Lock-Lee/Drumduino/hardware/enclosure/README.md

# กล่อง DrumDuino (สำหรับพิมพ์ 3D)

กล่องสำหรับแผ่น DrumDuino carrier v2 ขนาดภายนอกประมาณ **145.6 × 125.6 × 30.4 มม.**
กล่องแบ่งเป็น 2 ชิ้น คือ **ฐาน** กับ **ฝา** รอยแยกอยู่ตรงระดับกึ่งกลางรูแจ็คพอดี
รูแจ็คจึงเป็นครึ่งวงกลมทั้งในฐานและในฝา วางแผ่นที่บัดกรีแจ็คแล้วลงในฐานได้ตรง ๆ

## ไฟล์
- `drumduino-enclosure-base.stl` ฐาน พิมพ์โดยให้พื้นกล่องคว่ำลงบนฐานพิมพ์
- `drumduino-enclosure-lid.stl` ฝา หมุนไว้แล้ว ให้ผิวด้านบนของฝาวางบนฐานพิมพ์
- `drumduino-enclosure.scad` ไฟล์ต้นแบบ เปิดด้วย OpenSCAD เพื่อแก้ขนาดได้
- `drumduino-enclosure-*.png` ภาพตัวอย่าง

## การพิมพ์
- ใช้ PLA หรือ PETG ความหนาชั้น 0.2 มม. ผนัง 3 ชั้น เติมเนื้อใน 20%
- ไม่ต้องใช้ support เพราะรูครึ่งวงกลมอยู่ที่ขอบชิ้นงานพอดี

## การประกอบ
1. บัดกรีอุปกรณ์ทั้งหมดลงแผ่น รวมทั้งแจ็ค 16 ตัว
2. วางแผ่นลงในฐาน ให้หัวแจ็คลงในร่องครึ่งวงกลม และรูยึดแผ่นตรงกับเสารอง 4 ต้น
3. ปิดฝา
4. ใส่สกรู **M3 × 25 มม.** 4 ตัวจากใต้ฐาน สกรูจะทะลุเสารอง ผ่านรูของแผ่น แล้วเกลียวเข้าเสาของฝา
   เสาของฝาจะกดแผ่นลงบนเสารอง ทำให้แผ่นแน่น
5. ขันน็อตของแจ็คจากด้านนอกผนัง น็อตจะรับแรงเสียบสายแทนจุดบัดกรี
6. ติดยางรองใต้กล่อง 4 จุด เพราะหัวสกรูยื่นออกมาใต้ฐาน

## ค่าที่ควรวัดจากของจริงก่อนพิมพ์
ค่าเหล่านี้อยู่ส่วนบนของไฟล์ `.scad` ให้แก้ แล้วกด F6 และ Export STL ใหม่
| ค่า | ที่ตั้งไว้ | ความหมาย |
|---|---|---|
| `jack_axis_h` | 6.3 มม. | ความสูงจุดกลางหัวแจ็คจากผิวแผ่น ค่านี้กำหนดตำแหน่งรอยแยกฝากับฐานด้วย |
| `dc_axis_h` | 6.5 มม. | ความสูงจุดกลางรูแจ็คไฟ DC |
| `usb_axis_h` | 9.6 มม. | ความสูงจุดกลางพอร์ต USB ซึ่งอยู่ใต้บอร์ด Mega PRO |
| `screw_pilot_d` | 2.6 มม. | รูนำในเสาของฝาสำหรับสกรู M3 ถ้าแน่นไปให้เพิ่มเป็น 2.7 |

ตัวเลขชุดนี้ประมาณจากโมเดล 3D แบบคร่าว ๆ เพราะเปิดสเปคของจริงไม่ได้
**แนะนำให้พิมพ์ฐานก่อน 1 ชิ้นแล้วลองวางแผ่นจริง** ถ้าตรงแล้วค่อยพิมพ์ฝา

ไฟล์ `.scad` สร้างจาก `../gen_enclosure.py` ซึ่งอ่านตำแหน่งแจ็ค รูยึด และแจ็คไฟจากไฟล์ PCB โดยตรง
ถ้าแก้แผ่น PCB ให้รันสคริปต์ใหม่ กล่องจะตรงกับแผ่นเสมอ
