Lock-Lee/Drumduino/README.th.md

# DrumDuino

[English](README.md) · **ภาษาไทย**

แอปกลองไฟฟ้าสำหรับ macOS และ Windows ที่ต่อกับ Arduino และเซนเซอร์ piezo
ตีแป้นแล้วได้เสียงกลองจริง ฝึกตีตามโน้ตพร้อมเพลงต้นฉบับ และอัดคลิปลงโซเชียลได้ในแอปเดียว

หน้าฝึกตี: โน้ตกลอง เพลงประกอบที่ซิงก์แล้ว และชุดกลอง 3 มิติที่ไม้ตีตามโน้ต

## สิ่งที่ทำได้

**เสียงกลอง**
- ชุดกลองให้เลือก 6 ชุด: Studio Maple, Black Pearl, Red Zeppelin, Arena Metal, Salamander Garage (กลองอะคูสติกจริง หลายระดับแรงตี) และ Synth Kit
- ทำสำเนาเป็น "ชุดของฉัน" แล้วแก้เสียงได้ ปรับ EQ ทุ้ม / กลาง / แหลม แยกแต่ละชิ้น
- **ใส่ไฟล์เสียงเองได้หลายไฟล์ต่อชิ้น**: .wav .mp3 .ogg .flac .aiff (ลากมาวางได้) เล่นตามแรงตี (velocity layers) · วนตามลำดับ (round robin) · สุ่ม
- ปรับความดัง, pitch, ความไวเซนเซอร์, scan / mask time แยกแต่ละชิ้น แล้วส่งค่าไปบอร์ดให้อัตโนมัติ
- **ตีขอบได้ (dual-zone)**: piezo หนัง + piezo ขอบ มีเสียงขอบแยก (rimshot, ride bell, ขอบทอม)
- **แป้นไฮแฮท**: ปิด / ครึ่งเปิด / เปิด ตามความลึกที่เหยียบ, เสียงเหยียบ (chick), ปิดแป้นแล้วไฮแฮทเปิดหยุดทันที (choke), รองรับ MIDI CC4

**ฝึกตี**
- โน้ตกลองบนบรรทัด 5 เส้นแบบมาตรฐาน มีเคอร์เซอร์วิ่งตาม คลิกห้องไหนก็เริ่มเล่นจากห้องนั้น
- โหมด **แอปตีให้ฟัง** และ **ฉันตีเอง** (บอกว่าตีเร็ว / ช้ากี่ ms พร้อมคะแนน) · เมโทรนอม · นับก่อนเริ่ม · ปรับ BPM · วนซ้ำเฉพาะห้อง · เปลี่ยนชุดกลองได้ในหน้านี้
- **แท็บฝึกแบบเลน**: โน้ตวิ่งเป็นเลนสีตามแต่ละชิ้น บอกมือ L / R และเท้า RF / LF บนทุกโน้ต พร้อมชุดกลองนีออน
- **ชุดกลอง 3 มิติ**: ไม้กลองตีตามโน้ตจริงแบบลื่นเหมือนมือจับ (เงื้อรอโน้ตถัดไป แล้วฟาดลงตรงจังหวะ) สลับมือซ้าย-ขวาแบบมือกลอง (รัว / ฟิลล์ใช้ R L R L) ฉาบโยก หัวกระเดื่องฟาด คลิกที่กลองเพื่อตี ลากเพื่อหมุนมุมมอง
- **เพลงประกอบ + Auto Sync (ซิงก์เพลงอัตโนมัติ)**: ใส่ไฟล์เพลงจริง แอปหาเองว่าห้อง 1 อยู่วินาทีไหนและเพลงเร็วกี่ BPM แล้วเล่นเพลงตรงกับโน้ตทั้งเพลง ลดความเร็วแล้วเสียงไม่เพี้ยน
- จังหวะสำเร็จรูป (ร็อก ป๊อป ฟังก์ ดิสโก้ ชัฟเฟิล สวิง บอสซา 6/8 ลูกส่ง เพลงฝึกแบบมีท่อน) และนำเข้าโน้ตจาก MIDI / MusicXML (export จาก MuseScore ได้)

<p align="center">แท็บฝึกแบบเลน: ชุดกลองนีออน 3 มิติ ไม้กลอง L/R ยกขึ้นแล้วตีลงตามโน้ตที่วิ่งมาในเลน</p>

**อัดคลิป**
- **โหมดอัดคลิป** แนวตั้งหรือแนวนอน 16:9 ซ่อนเมนูทั้งหมด เหลือโน้ตกับชุดกลอง 3 มิติ
- สคริปต์ตั้งค่า OBS ให้ครบ ทั้ง Reels (9:16) และ YouTube (16:9): หน้าต่างแอปเต็มภาพ พร้อมเสียงจากเครื่อง

**ฮาร์ดแวร์**
- รับสัญญาณผ่าน USB Serial (ทุกบอร์ด) หรือ USB MIDI (Leonardo / Pro Micro) รองรับ Arduino Mega 16 ช่อง (A0–A15)
- มีแบบแผ่น PCB สำหรับ Mega 2560 PRO พร้อมแจ็ค 6.35 มม. 16 ช่อง และกล่องพิมพ์ 3D
- ไม่มี Arduino ก็ทดสอบด้วยคีย์บอร์ดได้ หรือ**ใช้ iPhone / iPad เป็นแป้นกลองไร้สาย**: เปิด *ตีจาก iPhone / iPad* ในแท็บฮาร์ดแวร์ แล้วสแกน QR แตะจอแล้วเสียงออกจาก Mac ผ่าน Wi-Fi (ชุดกลองแบบสมจริง กระเดื่องคู่ แตะหลายนิ้วพร้อมกันได้ ตีกลางแป้นดังกว่าขอบ กดค้างเพื่อเปิดไฮแฮท) กดเล่นแล้วจะมีวงแหวนสีหดเข้าหากลองที่ต้องตีถัดไป พร้อมบอกมือ L / R / RF / LF
- บันทึกอัตโนมัติ ไฟล์เสียงเก็บไว้ในเครื่อง

## ตัวอย่างการใช้งาน

### ตัวอย่างที่ 1: ฝึกตีตามเพลงจริงด้วย Auto Sync

1. ไปที่แท็บ **ฝึกตี** เลือกเพลงจากรายการทางซ้าย
2. ที่แถบ **เพลงประกอบ** กด **เลือกไฟล์เพลง…** แล้วเลือกไฟล์ mp3 / m4a / wav ของเพลงนั้น
3. รอ 3–5 วินาที แอปจะซิงก์ให้เอง แล้วขึ้นว่า ✓ ตรงกับโน้ตแล้ว
4. กด **Space** เพื่อเล่น เพลงจะเล่นอินโทรก่อน แล้วโน้ตเริ่มเดินตอนห้อง 1 พอดี

แถบเพลงประกอบหลังซิงก์: ห้อง 1 อยู่ที่ 0:04.0 ความเร็วจริง 145.9 BPM

ภาพนี้ใช้เพลงตัวอย่างที่สร้างจากโน้ต "เพลงฝึก: Arena Metalcore" (ในโน้ตเขียนไว้ 144 BPM)
โดยให้มีอินโทร 4 วินาทีก่อนกลองเข้า และเล่นเร็วกว่าโน้ตเล็กน้อยที่ 146 BPM
แอปหาได้ว่าห้อง 1 อยู่ที่ **0:04.0** และเพลงเร็ว **145.9 BPM** แล้วตั้งความเร็วตามเพลงให้เอง

| อยากทำ | ทำแบบนี้ |
|---|---|
| ฝึกช้าลง | เลื่อนแถบความเร็ว เพลงจะช้าลงตาม แต่เสียงร้องไม่เพี้ยน |
| ซ้อมเฉพาะท่อน | ใส่เลขห้องเริ่ม–จบ แล้วติ๊ก **วนซ้ำ** เพลงจะกระโดดตามไปท่อนนั้น |
| ได้ยินแต่เพลง แล้วตีเอง | เลือกโหมด **ฉันตีเอง** กลองของแอปจะเงียบ และมีคะแนนให้ |
| เพลงยังคลาดนิดหน่อย | กด **ปรับเอง** แล้วใช้ −/+ (เพลงมาก่อนกลอง → −, เพลงมาช้า → +) |

Auto Sync ได้ผลดีกับเพลงอัดในห้องอัดที่ความเร็วคงที่ และโน้ตเป็นเวอร์ชันเดียวกับไฟล์เพลง
ถ้าเพลงเร่งหรือช้าลงกลางเพลง หรือโน้ตมีจำนวนห้องไม่ตรงกับเพลง จะเริ่มคลาดตรงท่อนนั้น

### ตัวอย่างที่ 2: นำเข้าโน้ตจาก MuseScore

1. ใน MuseScore เปิดโน้ตกลองแล้วกด *File → Export → MIDI* (หรือ MusicXML)
2. ในแอปกด **นำเข้า MIDI / MusicXML** แล้วเลือกไฟล์

ถ้ามีหลายเพลง ให้กด **เปิดโฟลเดอร์** แล้ววางไฟล์ไว้ในโฟลเดอร์ `my-scores` แอปจะโหลดให้ทุกครั้งที่เปิด

```
my-scores/
├── เพลงที่ 1.mid
├── เพลงที่ 2.musicxml
└── ...
```

ตอนพัฒนาโฟลเดอร์นี้อยู่ที่ `./my-scores` ในโปรเจกต์ (ถูก gitignore ไว้ ไฟล์โน้ตส่วนตัวไม่ขึ้น git)
ส่วนแอปที่ติดตั้งแล้ว โฟลเดอร์จะอยู่ในโฟลเดอร์ข้อมูลของแอป
ชื่อท่อน (Marker) ในไฟล์ MIDI จะขึ้นเป็นกรอบชื่อท่อนบนโน้ต และกระโดดไปท่อนนั้นได้

### ตัวอย่างที่ 3: ใส่เสียงสแนร์ของตัวเอง 6 ระดับแรงตี

หน้าชุดกลอง: สแนร์มี 6 ไฟล์ แบ่งตามแรงตี 1–127

1. แท็บ **ชุดกลอง** กด **ทำสำเนา** เพื่อสร้างชุดของฉัน
2. คลิกที่ **Snare** แล้วลากไฟล์ `snare_01.wav` … `snare_06.wav` (เบาไปดัง) มาวางในกรอบด้านขวา
3. ตั้ง **การเล่นหลายไฟล์ → ตามแรงตี** แอปจะแบ่งช่วงแรงตีให้เอง (1–21, 22–42, … 107–127)
4. แท็บ **ตั้งค่า** ปรับความดัง pitch และ EQ ทุ้ม/กลาง/แหลม

### ตัวอย่างที่ 4: อัดคลิปตีกลองด้วย OBS

โหมดอัดคลิปแนวนอน 16:9: โน้ตด้านบน ชุดกลอง 3 มิติด้านล่าง

```bash
# ปิด OBS ก่อน แล้วรันครั้งเดียว (macOS)
python3 obs/setup_obs.py
open -a OBS --args --collection "DrumDuino Reels" --profile "DrumDuino Reels"
```

สคริปต์จะสร้างชุดฉากกับโปรไฟล์ 2 ชุด (60 fps คลิปเก็บที่ `~/Movies/DrumDuino`)

| ชุดฉาก / โปรไฟล์ | ขนาด | ใช้กับโหมดอัดคลิป | เหมาะกับ |
|---|---|---|---|
| DrumDuino Reels | 1080×1920 (9:16) | แนวตั้ง | Reels, TikTok, Shorts |
| DrumDuino | 1920×1080 (16:9) | แนวนอน (เต็มจอ) | YouTube |

แต่ละชุดมีฉากเดียวชื่อ **แอปเต็มจอ** คือโน้ตกับชุดกลอง 3 มิติเต็มภาพ ไม่มีกล้อง สลับชุดใน OBS ได้ที่เมนู *Scene Collection* และ *Profile*

ในแอปหน้าฝึกตีหรือฝึกแบบเลน กด **● อัดคลิป → แนวตั้ง** หรือ **แนวนอน (เต็มจอ)** หน้าต่างจะย่อแล้วย้ายไปตำแหน่งที่ OBS จับภาพไว้ (อย่าลากหน้าต่าง)
กด Space เพื่อเล่น / หยุด กด Esc เพื่อออก
เสียงที่อัดคือเสียงที่ Mac เล่นออกมา (กลอง + เพลงประกอบ) ตอนอัดให้เปิดโหมดห้ามรบกวน (Do Not Disturb) เสียงแจ้งเตือนจะได้ไม่ติดเข้าไป

### ตัวอย่างที่ 5: ลองเล่นโดยไม่มี Arduino

เปิดแอปแล้วใช้คีย์บอร์ดแทนแป้นกลอง

| ปุ่ม | กลอง | | ปุ่ม | กลอง |
|---|---|---|---|---|
| Q | Crash | | A | Hi-hat |
| W | Tom 1 | | S | Snare |
| E | Tom 2 | | D | Kick |
| R | Ride | | F | Floor Tom |

Shift ค้าง = ตีเบา · Option/Alt = ตีขอบ · X ค้าง = ไฮแฮทเปิด · Z = เหยียบแป้นไฮแฮท

## ฮาร์ดแวร์

| บอร์ด | ช่อง | วิธีส่ง |
|---|---|---|
| Arduino Nano | 8 (A0–A7) | USB Serial |
| Arduino Uno | 6 (A0–A5) | USB Serial |
| Arduino Mega | 16 (A0–A15) | USB Serial |
| Leonardo / Pro Micro | 8 | USB Serial + USB MIDI |

ต่อสายแต่ละช่อง: piezo (+) → ขาอนาล็อก, piezo (−) → GND, ตัวต้านทาน 1 MΩ คร่อมขาอนาล็อกกับ GND
(แนะนำ) ไดโอดซีเนอร์ 5.1V คร่อมกันแรงดันเกิน

ลงเฟิร์มแวร์: เปิด `firmware/DrumDuino/DrumDuino.ino` ด้วย Arduino IDE → เลือกบอร์ด/พอร์ต → Upload
(Leonardo / Pro Micro ต้องติดตั้งไลบรารี `MIDIUSB` ก่อน)

ค่าเริ่มต้นของขา: A0 Crash · A1 Hi-hat · A2 Snare · A3 Kick · A4 Tom 1 · A5 Tom 2 · A6 Floor Tom · A7 Ride

### แผ่น PCB และกล่อง (Mega 2560 PRO)

แผ่น DrumDuino Carrier v2 มุมมอง 3D กล่องพิมพ์ 3D ที่ประกอบแล้ว

- **แผ่น PCB 140 × 120 มม.:** แจ็ค 6.35 มม. 16 ช่อง มีวงจรป้องกันทุกช่อง (1 MΩ + ซีเนอร์ 5.1V) ช่องแป้นไฮแฮท และแจ็คไฟ DC
  ไฟล์ KiCad, Gerber สำหรับสั่ง JLCPCB และ BOM อยู่ที่ [`hardware/drumduino-carrier/`](hardware/drumduino-carrier/README.md)
- **กล่องพิมพ์ 3D:** ฐานกับฝาแยกกัน ยึดด้วยสกรู M3 × 25 มม. 4 ตัว ไฟล์ STL อยู่ที่ [`hardware/enclosure/`](hardware/enclosure/README.md)

ตัวอย่างการต่อแป้น: สาย piezo → แจ็คตัวผู้โมโน → เสียบช่อง A2 บนกล่อง → ในแอปจะขึ้นเป็น Snare ทันที

## รันตอนพัฒนา

ต้องมี [Node.js](https://nodejs.org) 20 ขึ้นไป

```bash
npm install
npm run dev        # เปิดแอปพร้อม hot reload
```

## ทำตัวติดตั้ง

```bash
npm run dist:mac   # ต้องรันบน Mac  → release/DrumDuino-x.y.z-arm64.dmg และ -x64.dmg
npm run dist:win   # ต้องรันบน Windows → release/DrumDuino Setup x.y.z.exe
```

### ให้ GitHub สร้างให้ทั้งสองระบบ (ไม่ต้องมีเครื่อง Mac/Windows)

มี workflow อยู่ที่ `.github/workflows/build.yml` แล้ว

1. push โปรเจกต์นี้ขึ้น GitHub
2. ติด tag เวอร์ชันแล้ว push: `git tag v0.1.0 && git push --tags`
3. รอประมาณ 10 นาที ไฟล์ `.dmg` และ `.exe` จะอยู่ในหน้า **Releases**
   (หรือกด Run workflow ในแท็บ Actions แล้วโหลดจาก Artifacts)

### หมายเหตุตอนติดตั้ง

ตัวติดตั้งยังไม่ได้เซ็นด้วยใบรับรองของ Apple/Microsoft จึงจะมีคำเตือนครั้งแรก:

- **macOS**: ลากแอปไปที่ Applications แล้วคลิกขวาที่แอป → Open → Open
  ถ้าขึ้นว่าแอป “เสียหาย” ให้รันใน Terminal: `xattr -cr /Applications/DrumDuino.app`
- **Windows**: ถ้าขึ้น SmartScreen ให้กด *More info* → *Run anyway*

ถ้าจะแจกให้คนทั่วไป ควรซื้อ Apple Developer ID ($99/ปี) และใบรับรอง code signing ของ Windows แล้วตั้งค่าใน electron-builder

## โปรโตคอล Serial (115200 baud)

ตัวอย่างข้อความจริงตอนเสียบบอร์ดแล้วตีสแนร์ ตีขอบสแนร์ และเหยียบไฮแฮทครึ่งทาง:

```
← I DRUMDUINO 1.2 16        บอร์ดแนะนำตัว: เฟิร์มแวร์ 1.2 มี 16 ช่อง
→ T 2 40                    แอปตั้ง threshold ของ A2 (Snare) = 40
← H 2 96                    ตีหนังสแนร์ แรง 96
← H 2 110 R                 ตีขอบสแนร์ แรง 110
← C 15 512                  แป้นไฮแฮท (A15) ค่ากลางระยะ ≈ ครึ่งเปิด (ขึ้นกับการตั้งแป้น)
```

รูปแบบข้อความทั้งหมด:

```
บอร์ด → แอป   I DRUMDUINO <version> <channels>
              H <channel> <velocity 1–127> [R]     R = ตีขอบ
              C <channel> <raw 0–1023>             ตำแหน่งแป้นไฮแฮท
แอป → บอร์ด   E <channel> <0|1>                    เปิด/ปิดขา
              T <channel> <threshold 0–1023>
              S <channel> <scan ms>
              M <channel> <mask ms>
              P <head channel> <rim channel|-1>    จับคู่ขาขอบกับขาหนัง
              X <head channel> <ratio %>           ตีขอบเมื่อ ขอบ ≥ หนัง × ratio/100
              K <channel> <0|1>                    1 = ขานี้เป็นแป้น (เซนเซอร์ต่อเนื่อง)
              ?
```

## โครงสร้าง

```
electron/        main process (หน้าต่าง, สิทธิ์ Serial/MIDI, ตัวเลือกพอร์ต, โหมดอัดคลิป)
src/audio/       เอนจินเสียง, ชุดเสียงในตัว, เพลงประกอบ + Auto Sync (backing.ts, align.ts)
src/input/       Serial, MIDI, คีย์บอร์ด
src/score/       โน้ต (VexFlow), ตัวเล่นโน้ต, นำเข้า MIDI/MusicXML, ชุดกลอง 3 มิติ, การสลับมือ
src/pages/       หน้าชุดกลอง / ฝึกตี / คลังเสียง / ฮาร์ดแวร์
firmware/        โค้ด Arduino
hardware/        แผ่น PCB (KiCad) และกล่องพิมพ์ 3D
obs/             สคริปต์ตั้งค่า OBS สำหรับอัดคลิป
docs/images/     ภาพประกอบใน README
```

## เครดิตเสียง

- **Studio Maple** — [Virtuosity Drums](https://versilian-studios.com/virtuosity-drums/) โดย Versilian Studios, ไลเซนส์ CC0
  มิกซ์จากไมค์ kick + snare + overhead และเลือกบางระดับแรงตีมาใช้ (`public/samples/LICENSE-VirtuosityDrums-CC0.txt`)
- **Black Pearl / Red Zeppelin** — [AVL Drumkits](https://github.com/studiorack/avl-drumkits) โดย Glen MacArthur ([bandshed.net](http://www.bandshed.net/avldrumkits/)),
  ไลเซนส์ [CC BY-SA 3.0](https://creativecommons.org/licenses/by-sa/3.0/) — แปลงเป็น OGG สเตอริโอ ตัดหางเสียงเงียบ และแพนตามไฟล์ SFZ ต้นฉบับ
  ไฟล์เสียงชุดนี้ (รวมที่แก้ไขแล้ว) แจกต่อภายใต้ CC BY-SA 3.0 เช่นเดิม (`public/samples/avl/LICENSE-AVL-Drumkits-CC-BY-SA-3.0.txt`)
- **Salamander Garage** — [Salamander Drumkit](https://github.com/studiorack/salamander-drumkit) โดย Alexander Holm (Rytmenpinne),
  ไลเซนส์ [CC BY-SA 3.0](https://creativecommons.org/licenses/by-sa/3.0/) — เลือก 3–8 ระดับแรงตีต่อชิ้น แปลงเป็น OGG ตัดความยาว และปรับระดับเสียงตามแรงตี
  ไฟล์ที่แก้ไขแล้วแจกต่อภายใต้ CC BY-SA 3.0 เช่นเดิม (`public/samples/sal/LICENSE-Salamander-Drumkit-CC-BY-SA-3.0.txt`)
- **Synth Kit** — สร้างขึ้นในแอป

## ลิขสิทธิ์

Copyright © 2026 Thirawut Khanpan **สงวนลิขสิทธิ์ทั้งหมด** โค้ด เฟิร์มแวร์ งานออกแบบ ไฟล์ PCB และกล่อง เป็นกรรมสิทธิ์ของผู้พัฒนา ห้ามคัดลอก ดัดแปลง เผยแพร่ต่อ หรือใช้เชิงพาณิชย์โดยไม่ได้รับอนุญาตเป็นลายลักษณ์อักษร ยกเว้นไฟล์เสียงกลองที่ระบุไว้ด้านบนซึ่งใช้สัญญาอนุญาตเดิมของเจ้าของ (CC0 / CC BY-SA 3.0) ดูรายละเอียดใน [LICENSE](LICENSE)
