Lock-Lee/Drumduino/hardware/drumduino-carrier/fab/drumduino-carrier-v2-3d-top.png

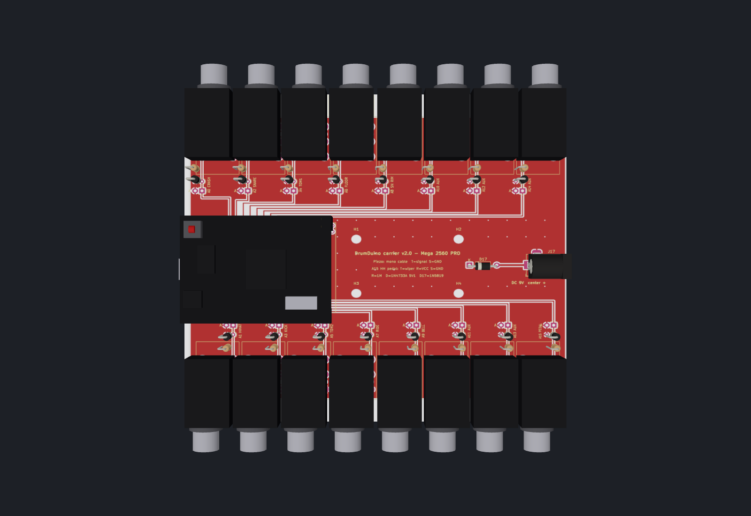
hardware/drumduino-carrier/fab/drumduino-carrier-v2-3d-top.png
