Lock-Lee/Drumduino/hardware/enclosure/drumduino-enclosure-open.png

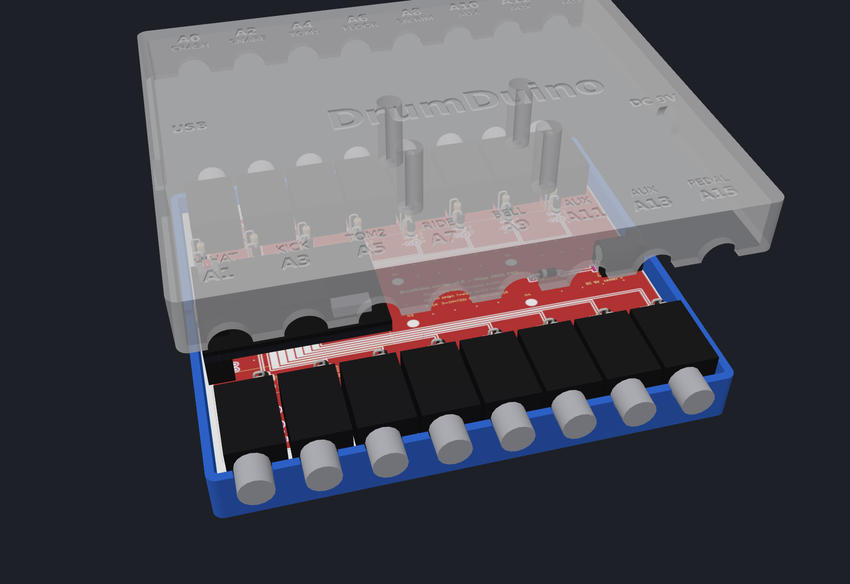
hardware/enclosure/drumduino-enclosure-open.png
