Lock-Lee/Drumduino/hardware/drumduino-carrier/3dmodels/D_DO-41_SOD81_P2.54mm_Vertical_AnodeUp.step

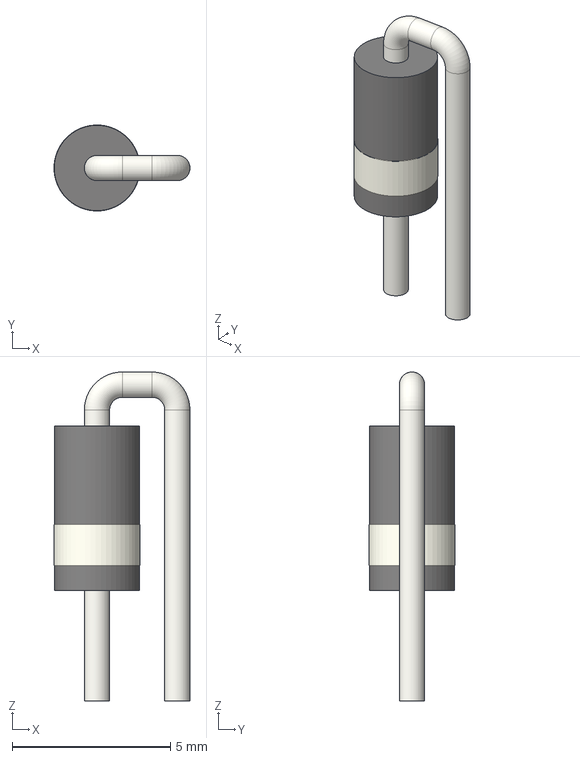
[picture p9: CAD file, 2026-10-29]
hardware/drumduino-carrier/3dmodels/D_DO-41_SOD81_P2.54mm_Vertical_AnodeUp.step
4.30 x 2.72 x 10.4 mm
