Lock-Lee/Drumduino/hardware/enclosure/drumduino-enclosure-base.stl

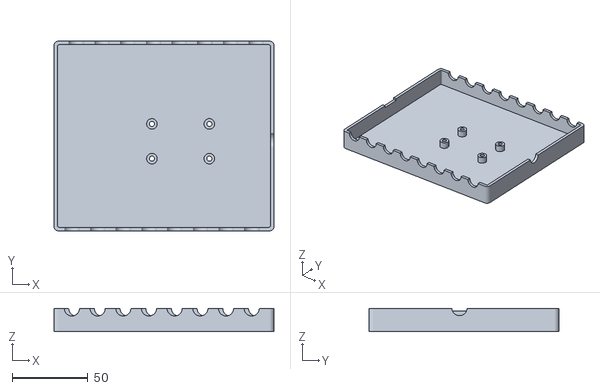
[picture p10: CAD file, 2026-10-29]
hardware/enclosure/drumduino-enclosure-base.stl
145.6 x 125.6 x 15.3
