Lock-Lee/Drumduino/hardware/drumduino-carrier/3dmodels/R_Axial_DIN0207_L6.3mm_D2.5mm_P2.54mm_Vertical.step

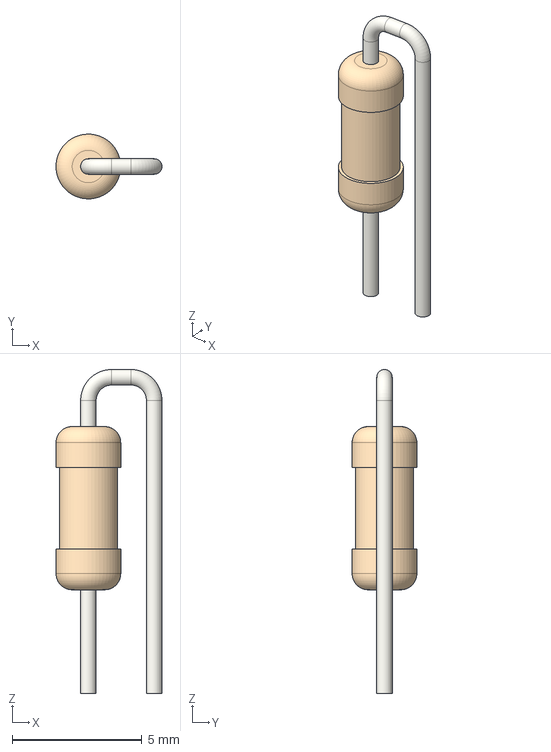
[picture p11: CAD file, 2026-10-29]
hardware/drumduino-carrier/3dmodels/R_Axial_DIN0207_L6.3mm_D2.5mm_P2.54mm_Vertical.step
4.09 x 2.50 x 12.5 mm
