Lock-Lee/Drumduino/hardware/enclosure/drumduino-enclosure-lid.stl

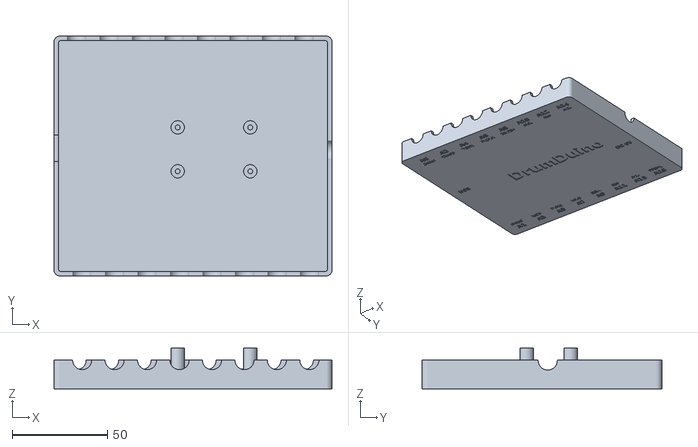
[picture p12: CAD file, 2026-10-29]
hardware/enclosure/drumduino-enclosure-lid.stl
145.6 x 125.6 x 21.4
