Lock-Lee/Drumduino/hardware/drumduino-carrier/3dmodels/BarrelJack_Horizontal.step

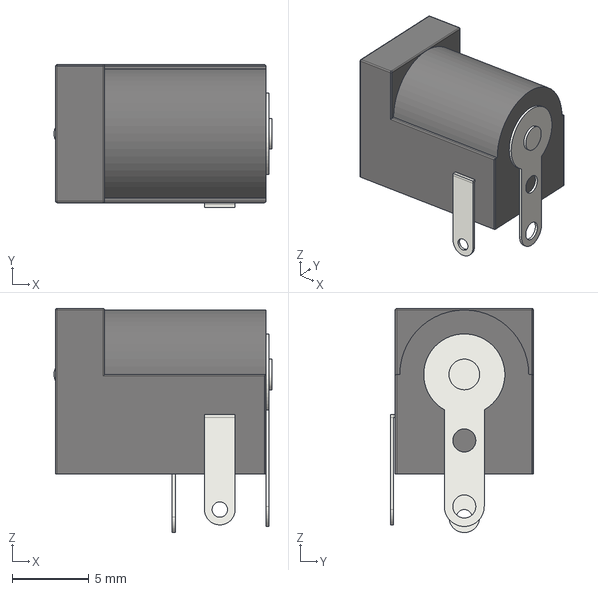
[picture p14: CAD file, 2026-10-29]
hardware/drumduino-carrier/3dmodels/BarrelJack_Horizontal.step
14.2 x 9.30 x 14.6 mm
