Lock-Lee/Drumduino/hardware/enclosure/drumduino-enclosure.scad

// DrumDuino enclosure — generated by gen_enclosure.py from the KiCad board. Units: mm.
// Board frame: X = board x, Y = board height - board y (so it reads the same as the PCB seen from above).
// Print: base with the floor on the bed; lid upside down (top on the bed). PLA/PETG, 0.2 mm layers, no supports needed.
$fn = 64;

/* [Measure these on your real parts and adjust] */
jack_axis_h = 6.3;    // jack nose centre above the PCB top
dc_axis_h   = 6.5;    // DC jack opening centre above the PCB top
usb_axis_h  = 9.6;    // micro-USB centre above the carrier PCB top (it is under the Mega PRO)
jack_hole_d = 10.0;   // 3/8" thread
dc_hole_d   = 10.0;
usb_w = 14; usb_h = 10;

/* [Box] */
wall = 2.4; floor_t = 2.4; top_t = 2.0;
gap = 0.4;            // board edge to inner wall
standoff_h = 5;       // board bottom above the floor
pcb_t = 1.6;
inner_h = 26;         // floor to lid inside (Mega PRO stack is about 16 mm above the PCB)
post_d = 7;
screw_clear_d = 3.4;  // M3 clearance through the base
screw_pilot_d = 2.6;  // M3 thread-forming into the lid posts (use 2.5–2.7 for PLA)

W = 140.000; H = 120.000;
pcb_top = standoff_h + pcb_t;
split_z = pcb_top + jack_axis_h;
top_jacks = [[11.945, "A0", "CRASH"], [28.945, "A2", "SNARE"], [45.945, "A4", "TOM1"], [62.945, "A6", "FLOOR"], [79.945, "A8", "SN RIM"], [96.945, "A10", "AUX"], [113.945, "A12", "AUX"], [130.945, "A14", "AUX"]];
bot_jacks = [[9.055, "A1", "HIHAT"], [26.055, "A3", "KICK"], [43.055, "A5", "TOM2"], [60.055, "A7", "RIDE"], [77.055, "A9", "BELL"], [94.055, "A11", "AUX"], [111.055, "A13", "AUX"], [128.055, "A15", "PEDAL"]];
mount = [[100.000, 45.000], [62.000, 45.000], [62.000, 68.000], [100.000, 68.000]];
dc_y  = 57.000;
usb_y = 55.990;

ox0 = -gap - wall; oy0 = -gap - wall;
OW = W + 2 * (gap + wall); OH = H + 2 * (gap + wall);
OZ0 = -floor_t; OZ1 = inner_h + top_t;

module rbox(x, y, z, w, h, d, r = 3) {
  translate([x, y, z]) hull() for (i = [r, w - r], j = [r, h - r]) translate([i, j, 0]) cylinder(r = r, h = d);
}
module shell() {
  difference() {
    rbox(ox0, oy0, OZ0, OW, OH, OZ1 - OZ0, 3);
    rbox(-gap, -gap, 0, W + 2 * gap, H + 2 * gap, inner_h, 1);
  }
}
module openings() {
  for (j = top_jacks) translate([j[0], H + gap - 1, split_z]) rotate([-90, 0, 0]) cylinder(d = jack_hole_d, h = wall + 2);
  for (j = bot_jacks) translate([j[0], -gap + 1, split_z]) rotate([90, 0, 0]) cylinder(d = jack_hole_d, h = wall + 2);
  translate([W + gap - 1, dc_y, pcb_top + dc_axis_h]) rotate([0, 90, 0]) cylinder(d = dc_hole_d, h = wall + 2);
  translate([-gap - wall - 1, usb_y - usb_w / 2, pcb_top + usb_axis_h - usb_h / 2]) cube([wall + 2, usb_w, usb_h]);
}
module labels() {
  d = 0.6;
  for (j = top_jacks) translate([j[0], H - 4.5, OZ1 - d]) {
    translate([0, 0, 0]) linear_extrude(d + 0.1) text(j[1], size = 3.4, halign = "center", valign = "center", font = "DejaVu Sans:style=Bold");
    translate([0, -5.2, 0]) linear_extrude(d + 0.1) text(j[2], size = 2.4, halign = "center", valign = "center", font = "DejaVu Sans");
  }
  for (j = bot_jacks) translate([j[0], 4.5, OZ1 - d]) {
    linear_extrude(d + 0.1) text(j[1], size = 3.4, halign = "center", valign = "center", font = "DejaVu Sans:style=Bold");
    translate([0, 5.2, 0]) linear_extrude(d + 0.1) text(j[2], size = 2.4, halign = "center", valign = "center", font = "DejaVu Sans");
  }
  translate([W / 2 + 12, H / 2, OZ1 - d]) linear_extrude(d + 0.1) text("DrumDuino", size = 9, halign = "center", valign = "center", font = "DejaVu Sans:style=Bold");
  translate([W - 9, dc_y - 9, OZ1 - d]) linear_extrude(d + 0.1) text("DC 9V", size = 3, halign = "center", valign = "center", font = "DejaVu Sans:style=Bold");
  translate([8, usb_y + 10, OZ1 - d]) linear_extrude(d + 0.1) text("USB", size = 3, halign = "center", valign = "center", font = "DejaVu Sans:style=Bold");
}
module base() {
  difference() {
    union() {
      intersection() { shell(); translate([ox0 - 1, oy0 - 1, OZ0 - 1]) cube([OW + 2, OH + 2, split_z - OZ0 + 1]); }
      for (m = mount) translate([m[0], m[1], 0]) cylinder(d = post_d, h = standoff_h);
    }
    openings();
    for (m = mount) translate([m[0], m[1], OZ0 - 1]) cylinder(d = screw_clear_d, h = standoff_h - OZ0 + 2);
  }
}
module lid() {
  difference() {
    union() {
      intersection() { shell(); translate([ox0 - 1, oy0 - 1, split_z]) cube([OW + 2, OH + 2, OZ1 - split_z + 1]); }
      for (m = mount) translate([m[0], m[1], pcb_top]) cylinder(d = post_d, h = inner_h - pcb_top + 0.01);
    }
    openings();
    labels();
    for (m = mount) translate([m[0], m[1], pcb_top - 1]) cylinder(d = screw_pilot_d, h = inner_h - pcb_top - 1);
  }
}

part = "both";   // "base", "lid", "both" (exploded preview)
if (part == "base") base();
else if (part == "lid_assembled") lid();
else if (part == "lid") translate([0, 0, OZ1]) rotate([180, 0, 0]) translate([0, 0, 0]) mirror([0, 0, 0]) lid();
else { color("#2d6cdf") base(); color("#e8e8e8", 0.85) translate([0, 0, 25]) lid(); }
