Lock-Lee/Drumduino/hardware/drumduino-carrier/fab/drumduino-carrier-schematic.pdf

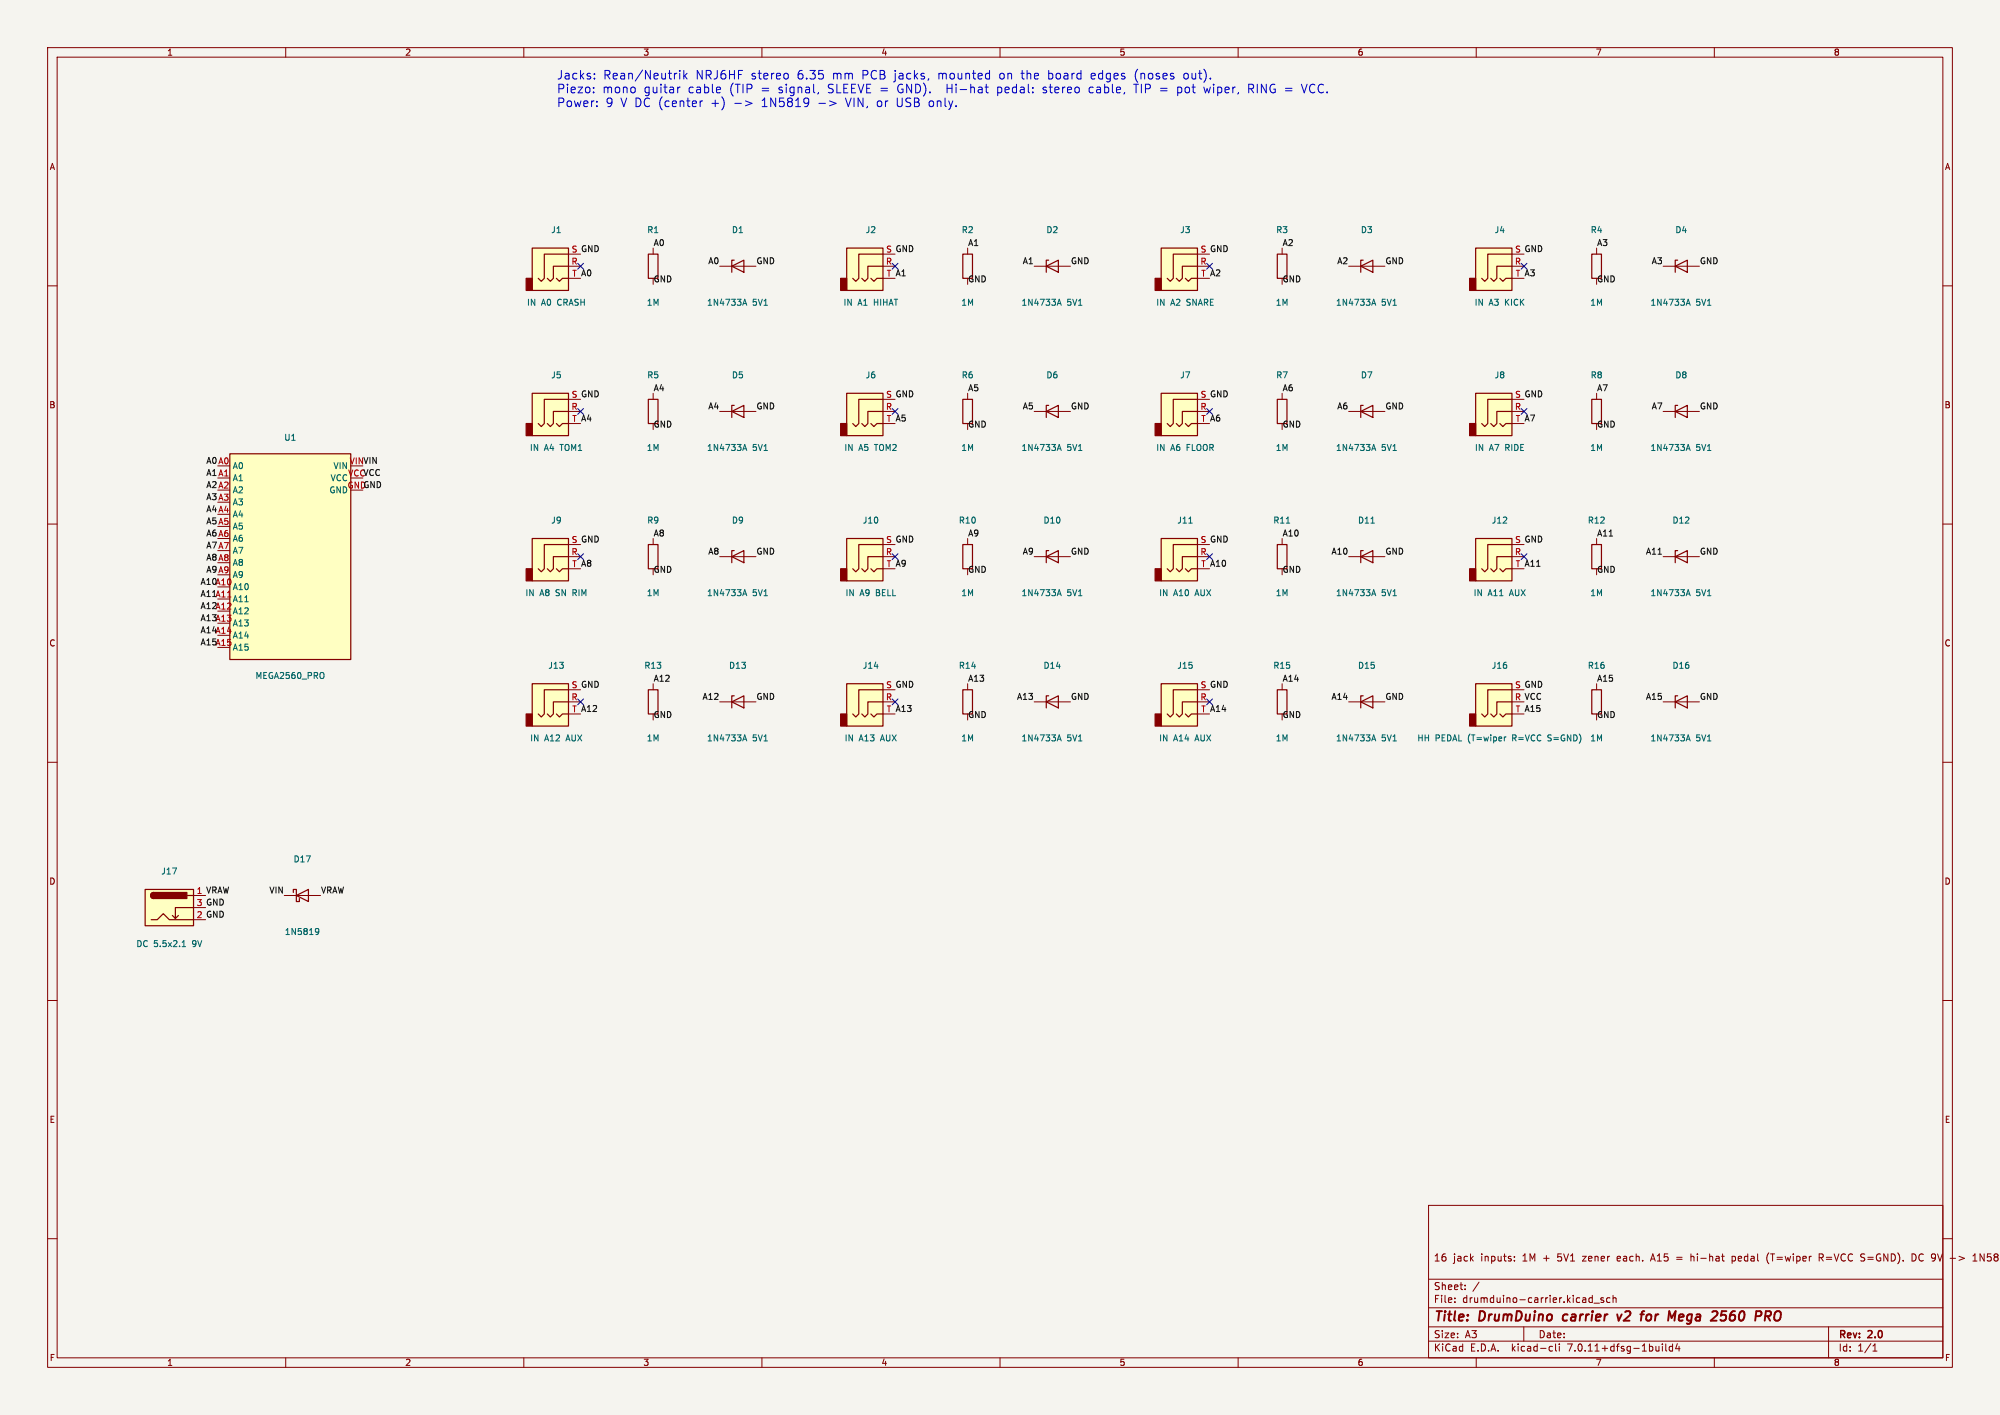
[picture p15: page 1]

Id: 1/1 Title: DrumDuino carrier v2 for Mega 2560 PRO
