Lock-Lee/Drumduino/hardware/drumduino-carrier/drumduino-carrier.kicad_pcb

## KiCad design hardware/drumduino-carrier/drumduino-carrier.kicad_pcb (2026-10-29)

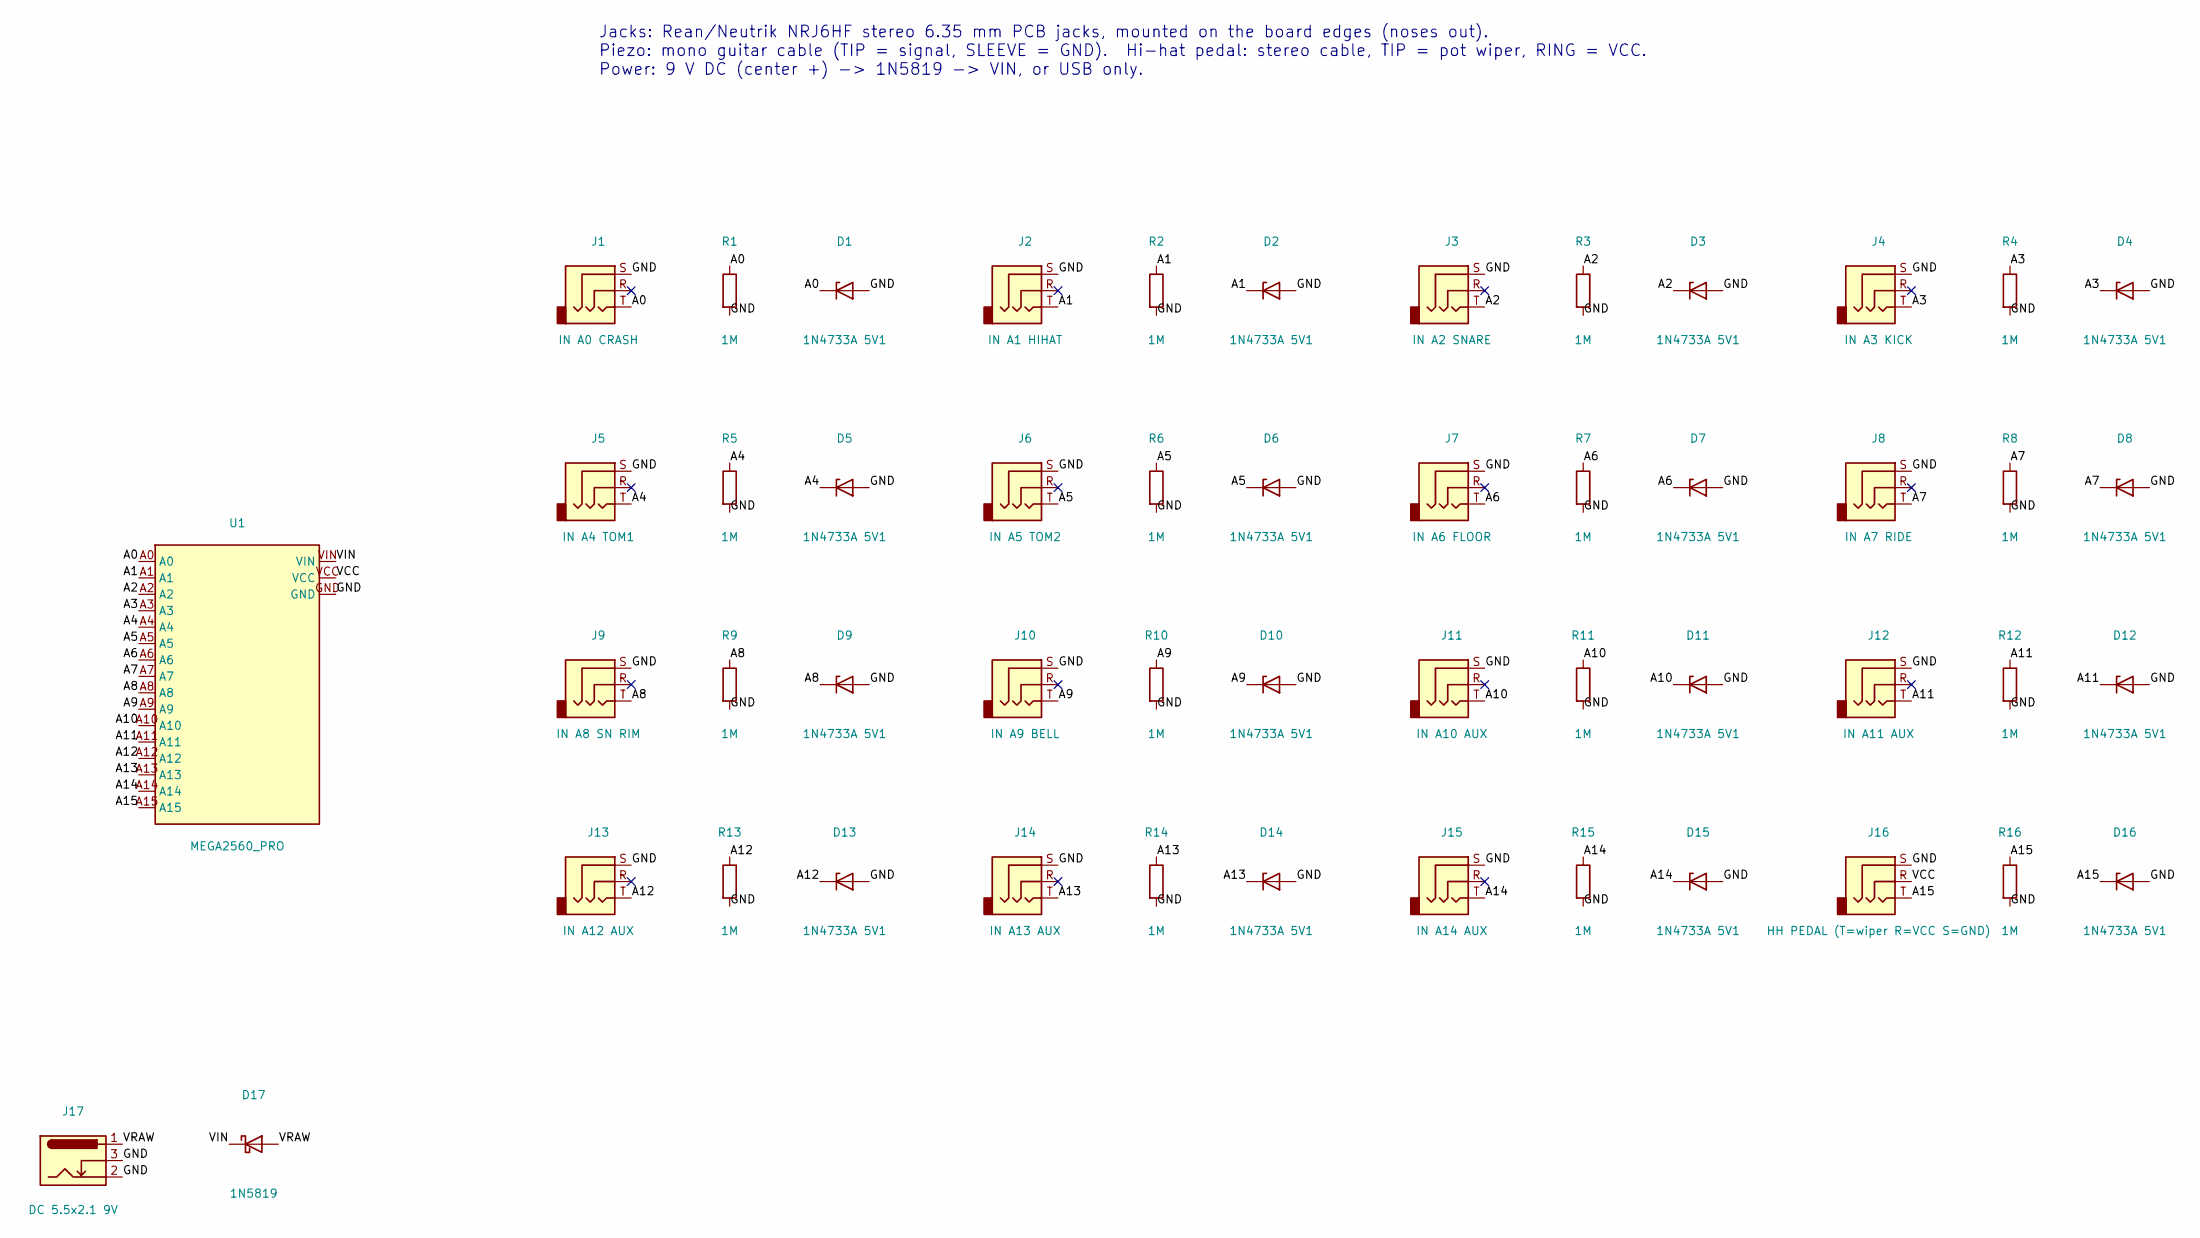
[picture p16: schematic drumduino-carrier.kicad_sch, DrumDuino carrier v2 for Mega 2560 PRO]

Parts:
D1, D2, D3, D4, D5, D6, D7, D8, D9, D10, D11, D12, D13, D14, D15, D16: 1N4733A 5V1; D_DO-41_SOD81_P2.54mm_Vertical_AnodeUp
D17: 1N5819; D_DO-41_SOD81_P10.16mm_Horizontal
J1: IN A0 CRASH; Jack_6.35mm_Neutrik_NRJ6HF_Horizontal
J2: IN A1 HIHAT; Jack_6.35mm_Neutrik_NRJ6HF_Horizontal
J3: IN A2 SNARE; Jack_6.35mm_Neutrik_NRJ6HF_Horizontal
J4: IN A3 KICK; Jack_6.35mm_Neutrik_NRJ6HF_Horizontal
J5: IN A4 TOM1; Jack_6.35mm_Neutrik_NRJ6HF_Horizontal
J6: IN A5 TOM2; Jack_6.35mm_Neutrik_NRJ6HF_Horizontal
J7: IN A6 FLOOR; Jack_6.35mm_Neutrik_NRJ6HF_Horizontal
J8: IN A7 RIDE; Jack_6.35mm_Neutrik_NRJ6HF_Horizontal
J9: IN A8 SN RIM; Jack_6.35mm_Neutrik_NRJ6HF_Horizontal
J10: IN A9 BELL; Jack_6.35mm_Neutrik_NRJ6HF_Horizontal
J11: IN A10 AUX; Jack_6.35mm_Neutrik_NRJ6HF_Horizontal
J12: IN A11 AUX; Jack_6.35mm_Neutrik_NRJ6HF_Horizontal
J13: IN A12 AUX; Jack_6.35mm_Neutrik_NRJ6HF_Horizontal
J14: IN A13 AUX; Jack_6.35mm_Neutrik_NRJ6HF_Horizontal
J15: IN A14 AUX; Jack_6.35mm_Neutrik_NRJ6HF_Horizontal
J16: HH PEDAL (T=wiper R=VCC S=GND); Jack_6.35mm_Neutrik_NRJ6HF_Horizontal
J17: DC 5.5x2.1 9V; BarrelJack_Horizontal
R1, R2, R3, R4, R5, R6, R7, R8, R9, R10, R11, R12, R13, R14, R15, R16: 1M; R_Axial_DIN0207_L6.3mm_D2.5mm_P2.54mm_Vertical
U1: MEGA2560_PRO; MEGA2560_PRO_Socket

Connections:
A0: D1.1 (K), J1.T, R1.1, U1.A0
A1: D2.1 (K), J2.T, R2.1, U1.A1
A2: D3.1 (K), J3.T, R3.1, U1.A2
A3: D4.1 (K), J4.T, R4.1, U1.A3
A4: D5.1 (K), J5.T, R5.1, U1.A4
A5: D6.1 (K), J6.T, R6.1, U1.A5
A6: D7.1 (K), J7.T, R7.1, U1.A6
A7: D8.1 (K), J8.T, R8.1, U1.A7
A8: D9.1 (K), J9.T, R9.1, U1.A8
A9: D10.1 (K), J10.T, R10.1, U1.A9
A10: D11.1 (K), J11.T, R11.1, U1.A10
A11: D12.1 (K), J12.T, R12.1, U1.A11
A12: D13.1 (K), J13.T, R13.1, U1.A12
A13: D14.1 (K), J14.T, R14.1, U1.A13
A14: D15.1 (K), J15.T, R15.1, U1.A14
A15: D16.1 (K), J16.T, R16.1, U1.A15
GND: D1.2 (A), D2.2 (A), D3.2 (A), D4.2 (A), D5.2 (A), D6.2 (A), D7.2 (A), D8.2 (A), D9.2 (A), D10.2 (A), D11.2 (A), D12.2 (A), D13.2 (A), D14.2 (A), D15.2 (A), D16.2 (A), J1.S, J2.S, J3.S, J4.S, J5.S, J6.S, J7.S, J8.S, J9.S, J10.S, J11.S, J12.S, J13.S, J14.S, J15.S, J16.S, J17.2, J17.3, R1.2, R2.2, R3.2, R4.2, R5.2, R6.2, R7.2, R8.2, R9.2, R10.2, R11.2, R12.2, R13.2, R14.2, R15.2, R16.2, U1.GND
VCC: J16.R, U1.VCC
VIN: D17.1 (K), U1.VIN
VRAW: D17.2 (A), J17.1

Notes on the sheet:
Jacks: Rean/Neutrik NRJ6HF stereo 6.35 mm PCB jacks, mounted on the board edges (noses out). Piezo: mono guitar cable (TIP = signal, SLEEVE = GND). Hi-hat pedal: stereo cable, TIP = pot wiper, RING = VCC. Power: 9 V DC (center +) -> 1N5819 -> VIN, or USB only.

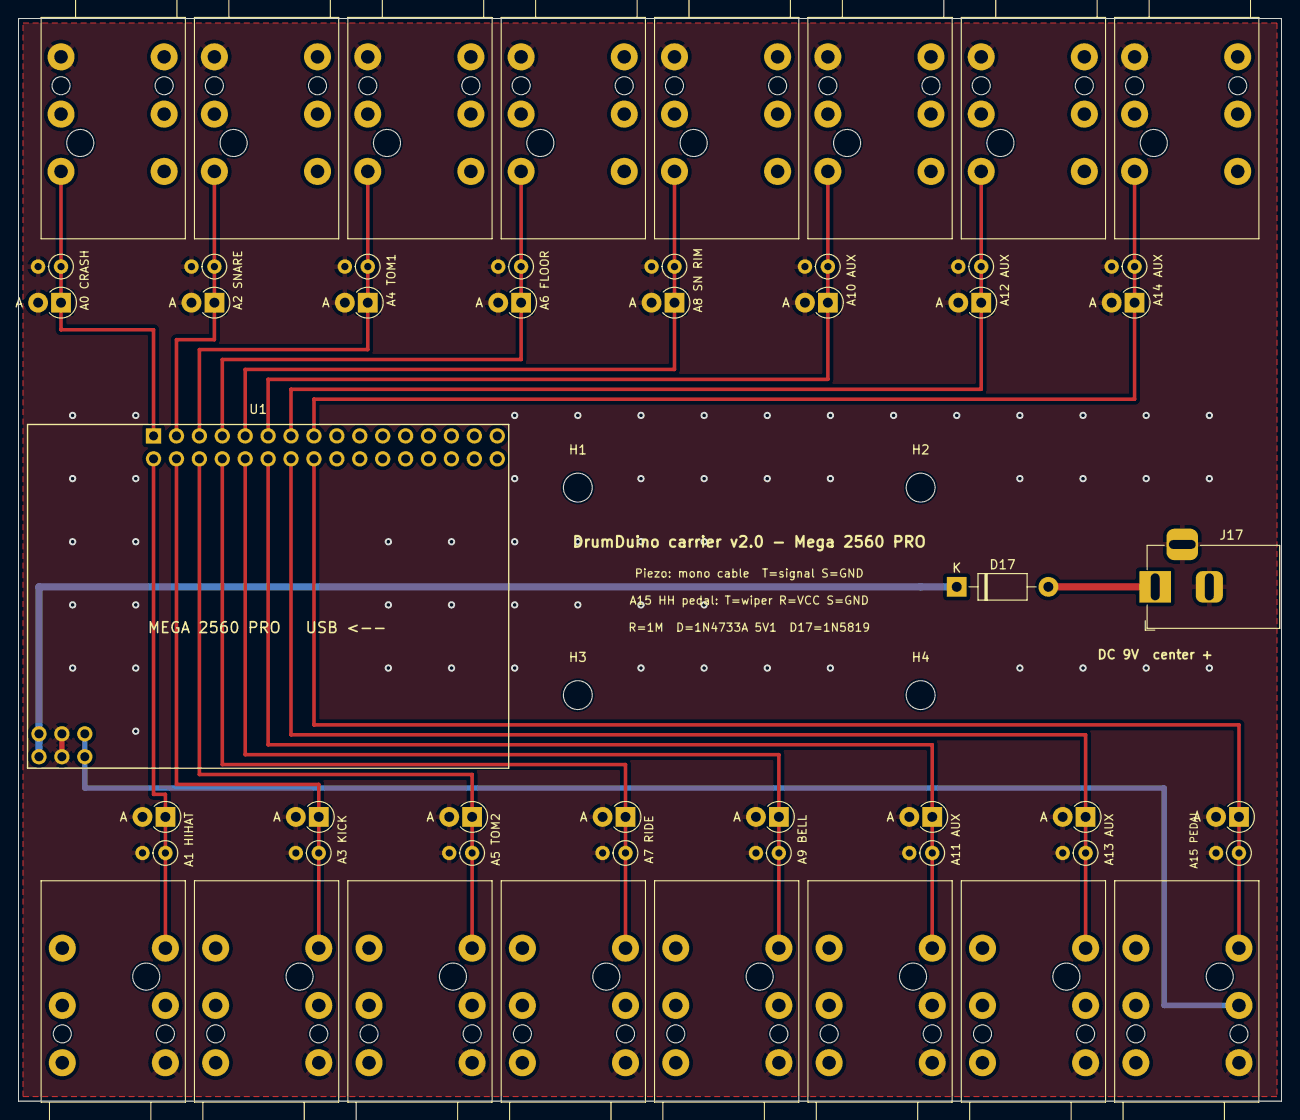
[picture p17: board drumduino-carrier.kicad_pcb from above]

Board: 2 copper layers, 140.0 x 120.0 mm, 55 parts (0 on the bottom side), 20 nets.

Other parts of the board:
H1, H2, H3, H4: MountingHole_3.2mm_M3
