Lock-Lee/Drumduino/(commit log)

2026-10-27 DrumDuino: Electron drum app + Arduino firmware
    Claude-Session: https://claude.ai/code/session_019Dkdmctnzo4hmTgGEA8k6P
2026-10-27 Use real acoustic drum samples (Virtuosity Drums, CC0) as default kit
    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
2026-10-27 Dual-zone (head/rim) pads, Arduino Mega 16 inputs
    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
2026-10-27 Hi-hat pedal: continuous sensor, half/open sounds, foot chick, choke, CC4
    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
2026-10-27 Practice page: choose drum kit (switches live while playing)
    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
2026-10-29 Hardware: KiCad carrier PCB for Mega 2560 PRO (16 protected inputs, hi-hat pedal), Gerbers for JLCPCB
    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
    [drumduino-carrier-B_Cu.gbl, drumduino-carrier-B_Mask.gbs, drumduino-carrier-B_Silkscreen.gbo, drumduino-carrier-Edge_Cuts.gm1, drumduino-carrier-F_Cu.gtl, drumduino-carrier-F_Mask.gts, drumduino-carrier-F_Silkscreen.gto, drumduino-carrier-NPTH.drl]
2026-10-29 Carrier v2: 16 Rean NRJ6HF edge jacks, DC 9V input with 1N5819, local 3D models (incl. Mega 2560 PRO)
    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
    [BarrelJack_Horizontal.step, D_DO-41_SOD81_P10.16mm_Horizontal.step, D_DO-41_SOD81_P2.54mm_Vertical_AnodeUp.step, R_Axial_DIN0207_L6.3mm_D2.5mm_P2.54mm_Vertical.step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]
2026-10-29 Enclosure: 3D-printable split box (OpenSCAD) generated from the carrier PCB
    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
    [drumduino-carrier-B_Cu.gbl, drumduino-carrier-B_Mask.gbs, drumduino-carrier-B_Silkscreen.gbo, drumduino-carrier-Edge_Cuts.gm1, drumduino-carrier-F_Cu.gtl, drumduino-carrier-F_Mask.gts, drumduino-carrier-F_Silkscreen.gto, drumduino-carrier-NPTH.drl]
2026-10-29 Restore carrier fab outputs
    [drumduino-carrier-B_Cu.gbl, drumduino-carrier-B_Mask.gbs, drumduino-carrier-B_Silkscreen.gbo, drumduino-carrier-Edge_Cuts.gm1, drumduino-carrier-F_Cu.gtl, drumduino-carrier-F_Mask.gts, drumduino-carrier-F_Silkscreen.gto, drumduino-carrier-NPTH.drl]
2026-10-30 Kit view: real sticking — both hands for simultaneous notes, alternate R/L on fast runs
    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
2026-10-30 Practice page: backing track — play your own recording of the song in sync with the score
    Stored per score in IndexedDB; offset (tap or ±0.01 s), volume; follows the tempo slider with pitch kept, seeks with the measure range and loops.
    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
2026-10-30 Backing track: automatic alignment (finds measure 1 and the recording's tempo), simpler panel
    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
2026-10-30 Backing track: play the whole song — intro before measure 1 and the ending after the last measure
    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
2026-10-30 Recording mode for OBS + OBS setup script (camera + DrumDuino window + app audio)
    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
2026-11-10 README: updated features, step-by-step examples with screenshots (Auto Sync, MIDI import, samples, OBS, keyboard), PCB/enclosure, serial example
    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
2026-11-12 WIP: lane view (note highway with L/R sticking) and shared pad colours — not wired into the page yet
    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
2026-11-12 New tab ฝึกแบบเลน: neon 3-D kit with L/R/RF/LF labels, section caption, and a scrolling instrument-lane view with sticking
    The classic ฝึกตี tab keeps the staff; both tabs can switch the kit between neon and realistic.
    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
2026-11-12 Thai / English UI: every string goes through t(), English dictionary in src/i18n/en.ts, ไทย | EN switch in the top bar
    Thai stays the source text in the code; the first run follows the system language.
    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
2026-11-12 Practice kit: sticks never freeze — idle breathing, and soft time-keeping in the air when no notes are near
    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
2026-11-13 WIP: iPhone as wireless drum pads — LAN server (not wired up yet)
    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
2026-11-13 Play from iPhone / iPad: phone screen as wireless drum pads over Wi-Fi
    The Mac app serves a pad page on the local network (port 8765, plain
    http + a minimal WebSocket server, no new runtime dependencies). Scan the
    QR code on the Hardware page; taps go straight into the sound engine as
    hits from source 'remote', so sticks, scoring and recording all work.
    Multi-touch, velocity from where the pad is hit, hold-to-open hi-hat,
    pads light up when the app plays, latency shown on the phone.
    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
2026-11-13 iPhone pads: easier to hit — touch events, gaps go to the nearest drum, bigger pieces away from the bottom edge, louder edge hits
    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
2026-11-13 License: all rights reserved (was MIT); drum samples keep their CC0 / CC BY-SA licenses
    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
2026-11-13 Recording: portrait window is now 9:16 for Reels; OBS setup without camera, desktop audio (fixes silent recordings), Reels 1080x1920 + YouTube 1920x1080 profiles
    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
2026-11-13 Practice: playing the whole song with a backing track runs to the song's real end instead of looping back to bar 1
    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
2026-11-13 Backing track: no seek storm — skip while seeking or starting, jump only past 0.3 s drift and at most every 2 s, otherwise nudge speed up to ±6%
    Long or VBR mp3 files report an inexact time right after a seek, which
    made follow() seek again every frame and stall the song mid-way.
    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
