Lock-Lee/Drumduino/(notices)

Notices in the files:
hardware/drumduino-carrier/3dmodels/R_Axial_DIN0207_L6.3mm_D2.5mm_P2.54mm_Vertical.step:
Copyright (C) 2017, kicad StepUp
This work is licensed under the [Creative Commons CC-BY-SA 4.0 License](https://creativecommons.org/licenses/by-sa/4.0/legalcode),
with the following exception:
To the extent that the creation of electronic designs that use 'Licensed Material' can be considered to be 'Adapted Material',
You are free to use the library data in your own projects without the obligation to share your project files under this or any other license agreement.
